kmizta/m5stack-co2-monitor/img/kit_complete_s.jpg

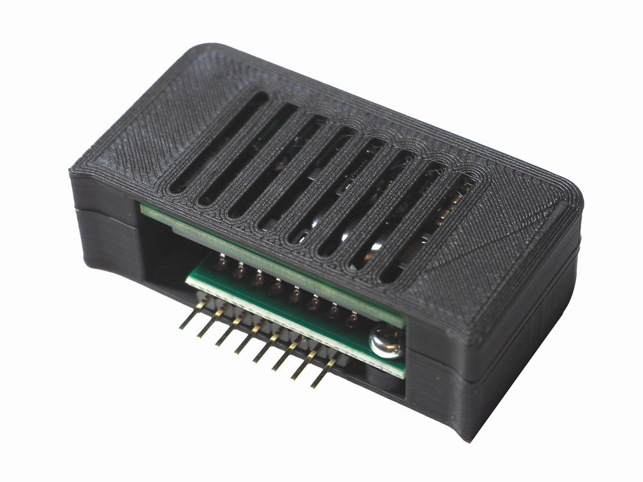
img/kit_complete_s.jpg
