kmizta/m5stack-co2-monitor/img/kit_content_s.jpg

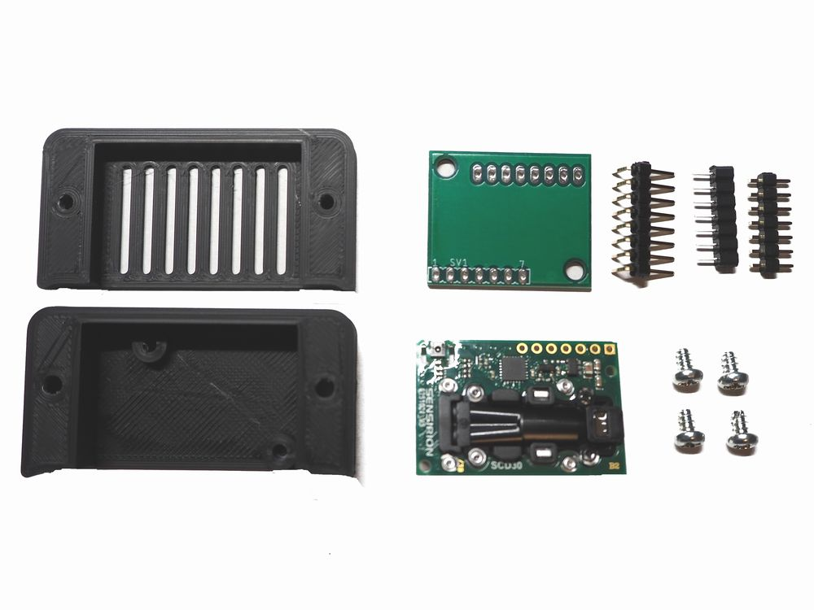
img/kit_content_s.jpg
