kmizta/m5stack-co2-monitor/img/kit_use_s.jpg

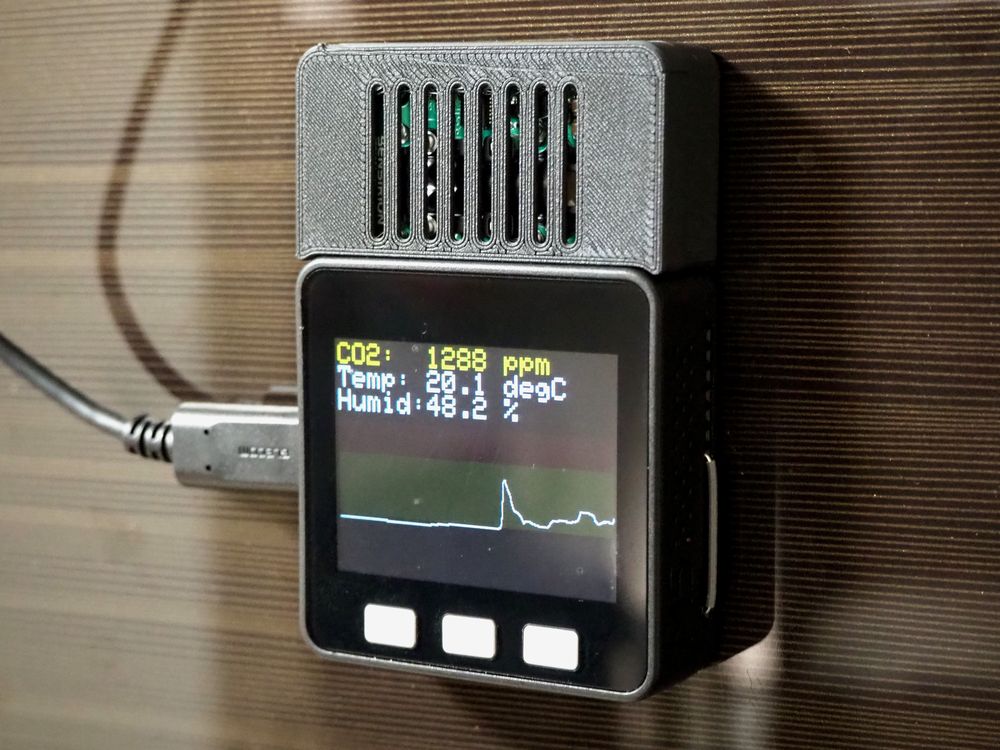
img/kit_use_s.jpg
