kmizta/m5stack-co2-monitor/(threads)

Thread 2 (2021-01-26):

M5Stack not showing any result.

RobMBSos, 2021-01-26:
Dear @kmizta
I am testing your .ino code but I can't make it work. I commented, "ambient" and "pushbullet" but it seems it is not able to work.
I am programming it via Arduino IDE with the M5Stack board selected and the process goes without any error and in the terminal, I could read that the initialization was good but no messages like "waiting for new data" or CO2 parameters, the display seems to not initialize.
I did some tests with examples and the M5Stacks seems to work fine with display examples and "factory test", any thoughts?
Thanks in advance.

kmizta, 2021-01-26:
Hi @RobMBSos
Could you please try v1.0 of this repository?
There's no relevant code to ambient or pushbullet in v1.0.
v1.0 is suitable If you don't use them, and it will work.

RobMBSos, 2021-01-26:
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

Hi @kmizta and thanks for your help. I used v1.0 code and programmed it but it seems I am having the same problem.
The display is off and there is no data at the terminal, tested with two different type C cables.

kmizta, 2021-01-27:
Hi @RobMBSos
Did you see serial console when you power M5Stack?
SCD30 might not be connected properly.
If SCD30 is  not connected properly, M5stack outputs "Air sensor not detected." to serial console.
Please check wiring and serial console.

RobMBSos, 2021-01-27:
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

Dear @kmizta
No serial console data when program is uploaded.
SCD30 tested but not a message in the serial console. I Will try to test the library is working and update you. Thanks for your time.

Thread 3 (2021-03-21):

証明書が無い場合新しいバージョンのライブラリでコンパイルするとpushの通信で失敗するみたいです。

sakana74, 2021-03-21:
この手のオープンソース関係に投稿するのは慣れていないので、場違いであったらごめんなさい
push通知が送られていなくておかしいなと思って追いかけていたところ
secureClient.setInsecure();
が無いと新しいライブラリではsecureClient.connectが失敗するみたいです。
同じような問題にぶつかっていた方が居ましたので参考のリンクも貼っておきます。
https://www.motohasi.net/blog/?p=3885

sakana74, 2021-03-21:
あ、コンパイルが失敗するのではなく、通信が失敗です。

kmizta, 2021-03-22:
@sakana74 さん、コメントありがとうございます。
こちらの環境では使用している各ライブラリをアップデートしても再現しないのですが、使用されている環境やライブラリのバージョン等教えていただけますか？

sakana74, 2021-03-23:
了解です。
手元の情報取り敢えず判る限りに羅列します。
環境としては
Visual Studio code  1.54.2
PlatformIO
Core 5.1.1 Home 3.3.4
M5Stack 0.3.1
WiFiClientSecure by Evandro Luis Copercini    1.0

あとはM5Stack Basicは在庫切れになっていたので、M5Stack Grayを利用していることでしょうか

気になってWiFiClientSecure のバージョン調べてみましたが1.0でした。何か他にも要因あるのでしょうか......
https://github.com/esp8266/Arduino/issues/4826
ココでもsetInsecure使え言われているみたい。
https://intellectualcuriosity.hatenablog.com/entry/2021/03/17/180935
最近なのでしょうか......この記事の日付は3/17ですし

sakana74, 2021-03-23:
https://github.com/esp8266/Arduino/issues/5277
これですかね....

kmizta, 2021-03-25:
@sakana74 さん、情報ありがとうございます。
platformioのPlaform updatesからEspressif 21のバージョンを2.1.0から最新の3,1,1に更新したところ、WifiClientSecureのソースコードも更新され、現象が再現しました。
いただいた情報をもとに修正を試みます。

kmizta, 2021-03-25:
ひとまず、setInsecure()をconnect()前に行うことで問題を回避し、正常にPushbulletへ通知できることを確認しました。
v3.1をPushしましたので、そちらをお使いください。
コメントありがとうございました。

Closed 2021-03-25.
