kmizta/m5stack-co2-monitor/(commit log)

2021-01-18 load from arduino ODE
2021-01-18 change file name and fix
    [main.cpp]
2021-01-26 add co2 calibration, temperature offset
2021-02-11 スイッチサイエンスでの委託販売に合わせて全面改訂
2021-04-05 add timer to be back main display
2021-04-08 Arduino IDEから書き込むと正常に起動しない場合がある旨追記
2021-04-08 bug fix: delete Serial.begin() in setup()
    [main.cpp]
